jesrockr/stm32_f9p_gnss_logger/assets/BASEWIRINGDIAGRAM.png

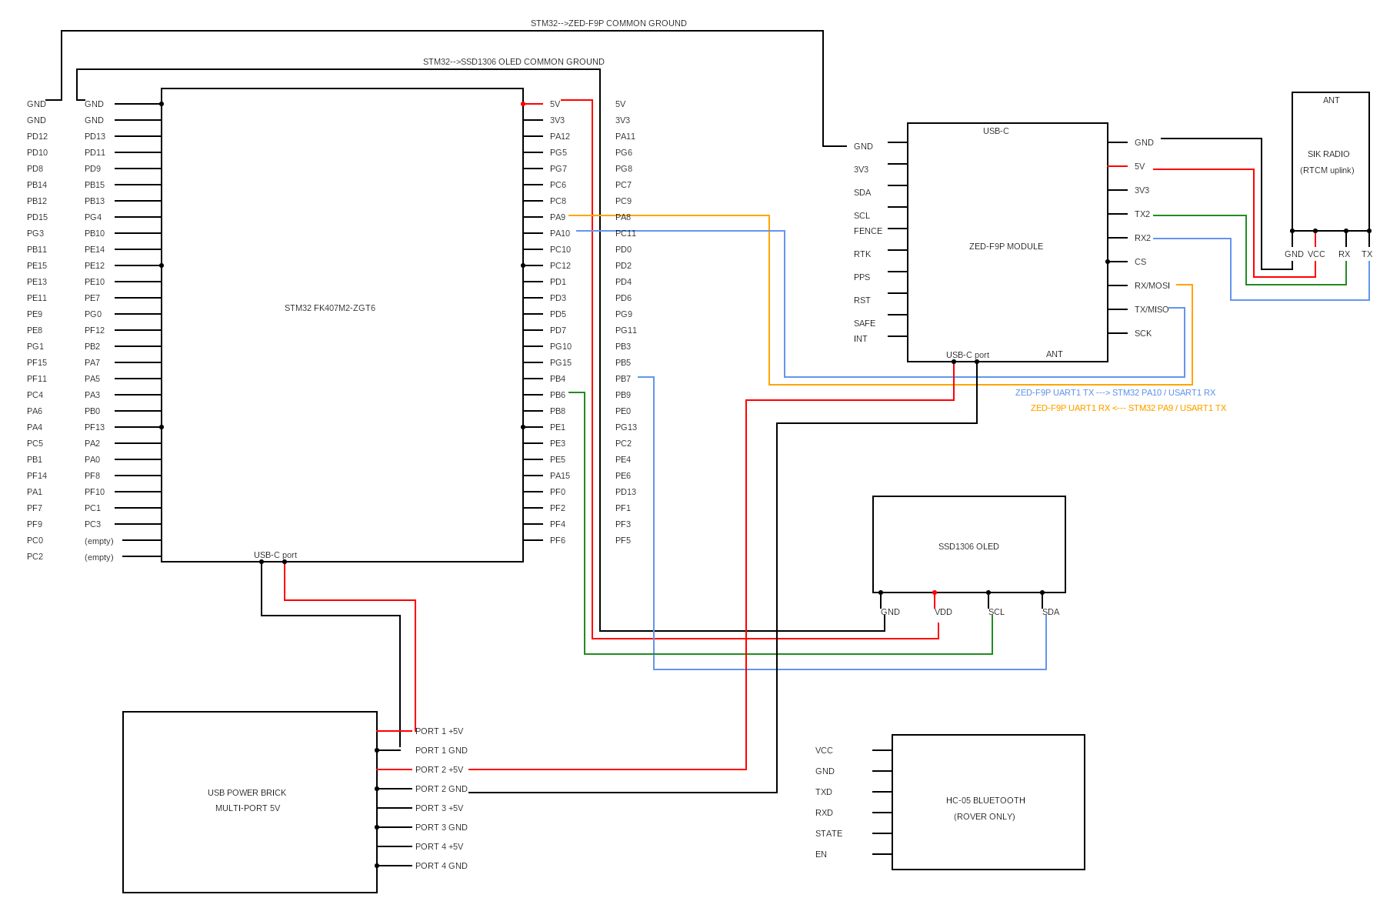
assets/BASEWIRINGDIAGRAM.png
