jesrockr/stm32_f9p_gnss_logger/TODO.md

# TODO

## Eventually

- Add `SURVEYING IN` live accuracy update (ex: `0.79M`) and/or remaining time counter (ex: `405/600s`)
- Add photos of the assembled logger.
- Add u-center screenshots or step-by-step F9P config export.
- Add build/import instructions for STM32CubeIDE.
- Add long-duration logging test results.

## Nice-To-Have Improvements

- Add case/enclosure notes.
- Add power consumption notes.
- Add PPK processing example workflow.
- Youtube video on build
