jesrockr/stm32_f9p_gnss_logger/(commit log)

2026-06-04 Rename gnss log test 2.ioc to STM32_GNSS_BASE.ioc
2026-06-05 Rename BASE WIRING DIAGRAM.png to BASE_WIRING_DIAGRAM.png
2026-06-05 Update README.md
    removed button functionality, that now lives in ROVER
